alru-git/UVsensor/docs/UVSensor_Gesamtaufbau.JPG

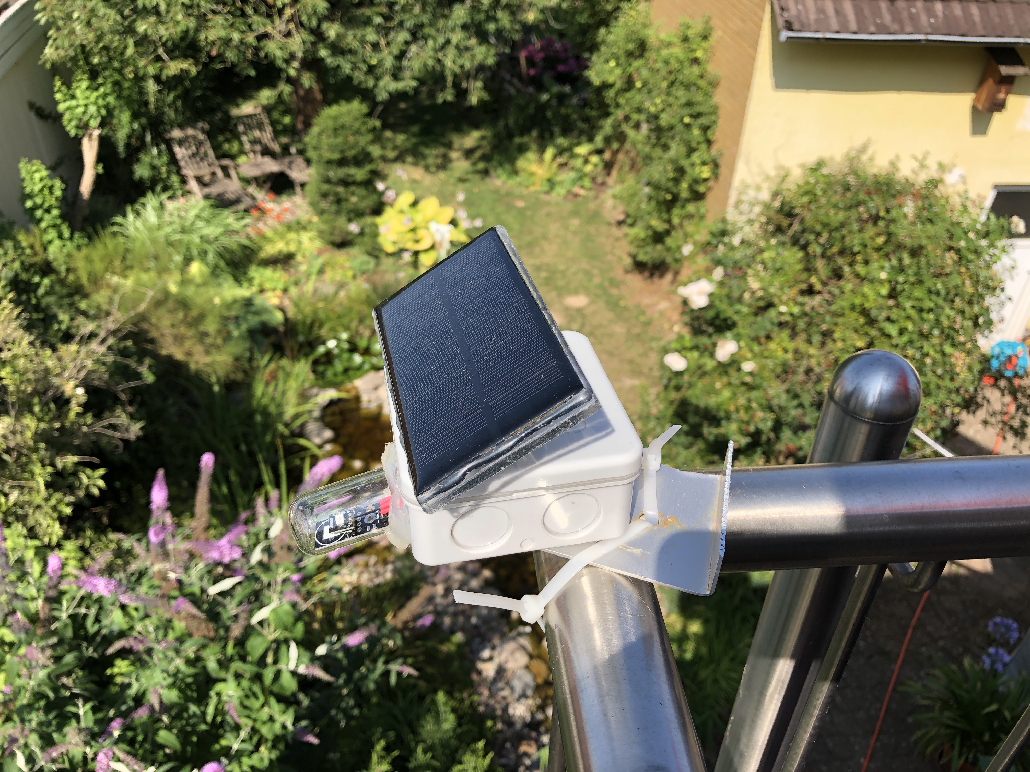
docs/UVSensor_Gesamtaufbau.JPG
