alru-git/UVsensor/docs/UVSensor_Detailansicht.JPG

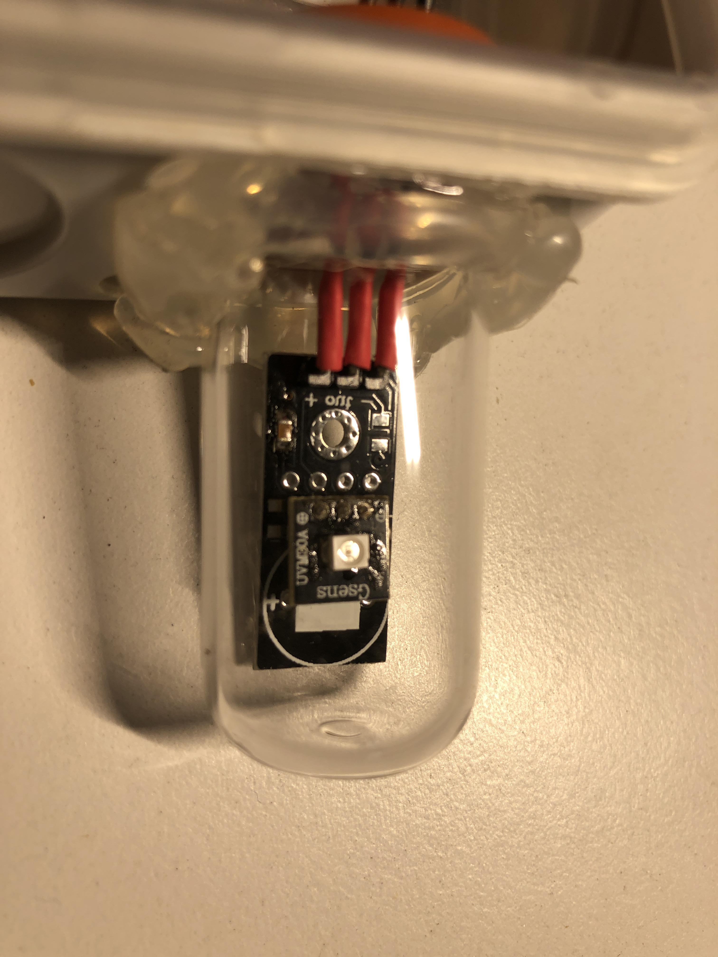
docs/UVSensor_Detailansicht.JPG
