alru-git/UVsensor/README.md

# UVsensor
Messung des UV-Index mit UVM-30A Sensor

Genutzte Technologien:

- Arduino (Controller für die Sensoren, https://store.arduino.cc/arduino-pro-mini)

- Mysensors (Radio Gateway, https://www.mysensors.org/)

- Fhem (Hausautomation Controller, https://fhem.de/)

Inhalt:

/docs: Dokumentation des Projektes (Zusammenfassung: UVsensor_doku.pdf)

/src: Code
