alru-git/UVsensor/docs/UVSensor_Innenansicht.JPG

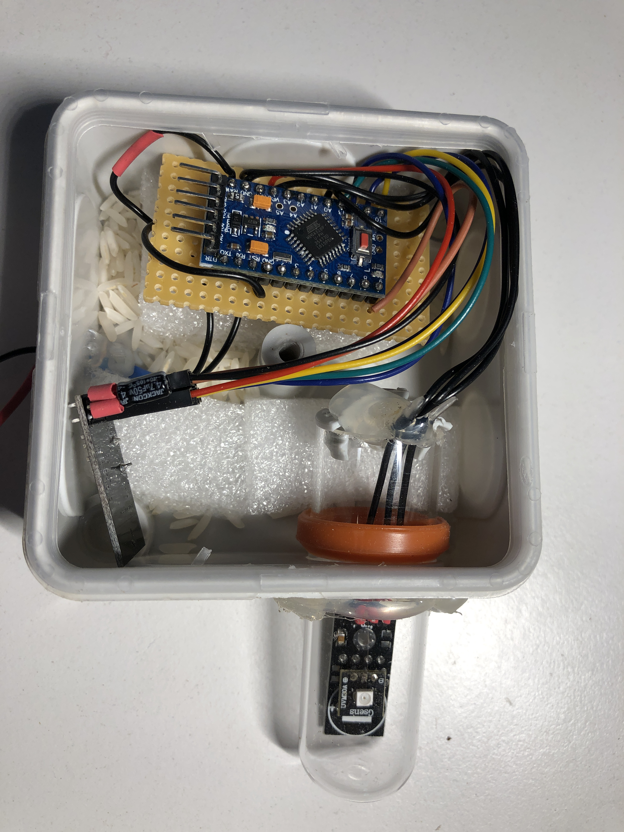
docs/UVSensor_Innenansicht.JPG
