alru-git/UVsensor/docs/Schematic_UVsensor (Solarbetrieb)_2021-05-05.pdf

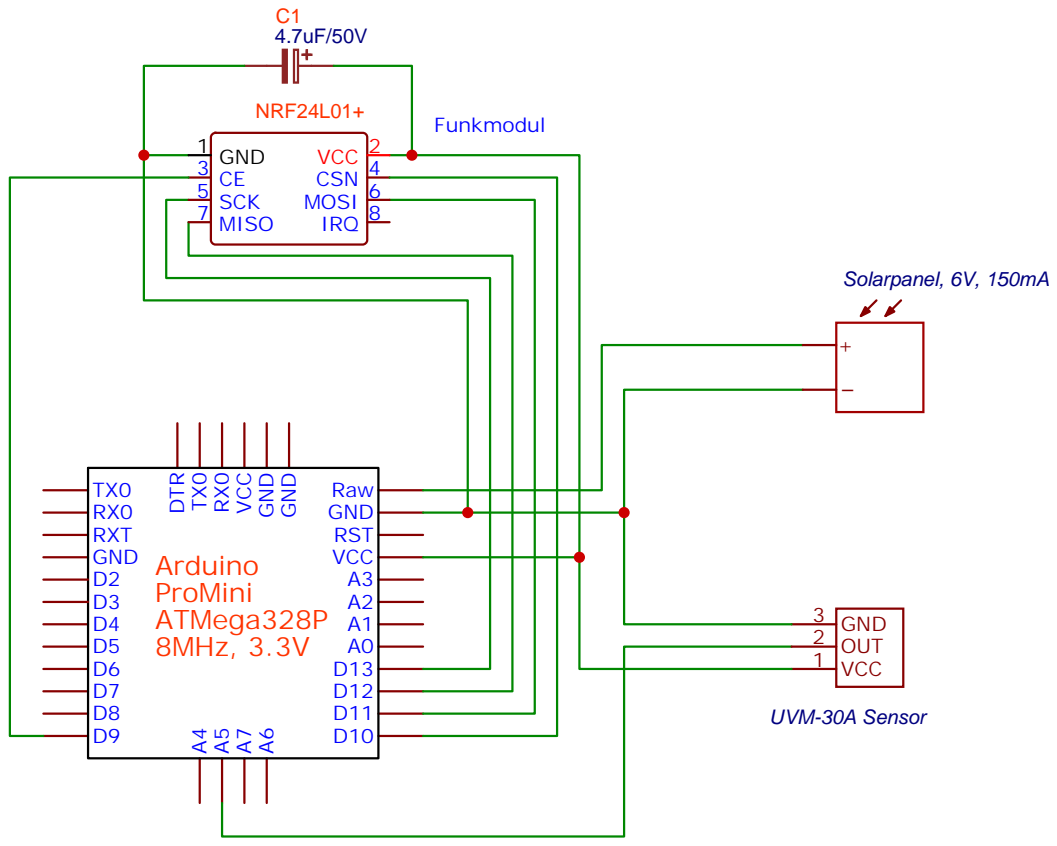
[picture p5: page 1]

Drawn By: Stefan Burkhardt
