alru-git/UVsensor/docs/Schematic_UVsensor-Solarbetrieb_Sheet-1_20190629221318.pdf

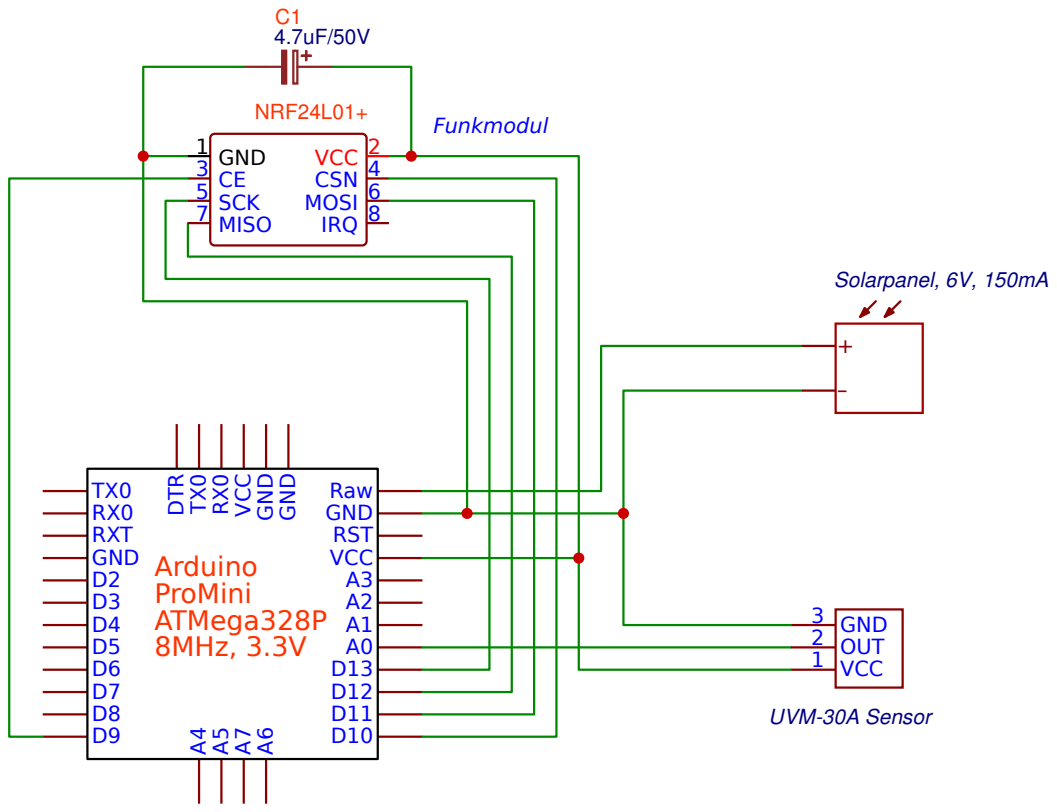
[picture p6: page 1]

Drawn By: Stefan Burkhardt
