alru-git/UVsensor/docs/UVSensor_mit_Solarpanel.JPG

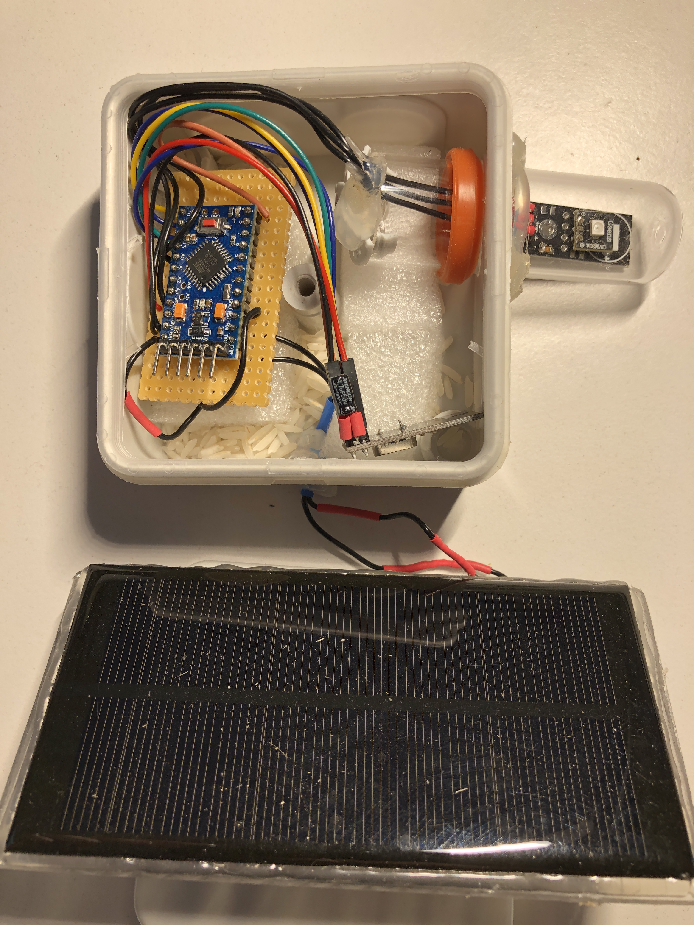
docs/UVSensor_mit_Solarpanel.JPG
